AP-IT-GH/iot16-park-assist/src/parkeersensor/PCB design/README.md

##PCB design
In deze folder is het PCB design en multisim schema te vinden. Dit multisim schema is nodig geweest om tot het PCB design te komen.
In deze 2e revisie is er gekozen voor een grotere form factor waardoor alle componenten aan de bovenkant kunnen komen.
Als ook de hoeken zijn nu afgehoekt zodat dit overeenkomt met ons 3D case design.
Tevens enkele kleine componenten zijn toegevoegd zoals:
 - Led
 - Power switch
