AP-IT-GH/iot16-park-assist/doc/README.md

<!-- START doctoc generated TOC please keep comment here to allow auto update -->
<!-- DON'T EDIT THIS SECTION, INSTEAD RE-RUN doctoc TO UPDATE -->
**Table of Contents**  *generated with [DocToc](https://github.com/thlorenz/doctoc)*

- [Internet of Things - [Naam Project]](#internet-of-things---naam-project)

<!-- END doctoc generated TOC please keep comment here to allow auto update -->

# Internet of Things - [Naam Project]
Documentatie voor het project voor het vak Internet of Things.
