AP-IT-GH/iot16-park-assist/doc/deliverables.md

<!-- START doctoc generated TOC please keep comment here to allow auto update -->
<!-- DON'T EDIT THIS SECTION, INSTEAD RE-RUN doctoc TO UPDATE -->
**Table of Contents**  *generated with [DocToc](https://github.com/thlorenz/doctoc)*

- [Deliverables](#deliverables)
  - [Projectplan](#projectplan)
    - [Team](#team)
    - [Project keuze](#project-keuze)
    - [Projectbeschrijving](#projectbeschrijving)
    - [Functionele analyse:](#functionele-analyse)
      - [Technologieën](#technologie%C3%ABn)
      - [Inventarisatie Hardware](#inventarisatie-hardware)
      - [High Level Diagrammen](#high-level-diagrammen)
      - [Project Planning](#project-planning)
        - [Backlog:](#backlog)
        - [Planning](#planning)
  - [PCB Design](#pcb-design)
    - [1ste Versie](#1ste-versie)

<!-- END doctoc generated TOC please keep comment here to allow auto update -->

# Deliverables
Richtlijnen voor de te inleveren documenten.

**Dit zijn richtlijnen voor de documentatie. U bent zelf verantwoordelijk voor
de relevante documentatie**

## Projectplan
### Team
Mededeling van alle teamleden en een mapping naar de GitHub account (Dit is
voor niet identificeerbare gebruikersnamen bv: OurDarkLord) 

### Project keuze
Vermelding van toegeweze project.

### Projectbeschrijving 
Beschrijving van de team visie over het project, alle voorziene
project beschrijvingen zijn minimaal, er zijn nog enkele uitbreidingen /
features nodig om het project te laten slagen.

Minimaal 3000 tekens.

### Functionele analyse:
#### Technologieën
Verkenning van het technisch landschap, hier beschrijf je de technologieën die
interessant kunnen zijn voor jullie project. Je koppelt deze beschrijving met
functionaliteit / feature van het project. Je doet dit zowel voor hardware als
software.

#### Inventarisatie Hardware
Je maakt een lijst met de nodige hardware voor het project

#### High Level Diagrammen
Je maakt diagrammen die op een abstracte manier beschrijven hoe de
verschillende componenten aan elkaar hangen. Informatie dat je hier nog mee kan
weergeven zijn communicatie patronen, koppeling van hardware componenten. Dit
kunnen ook high level flowcharts zijn.

#### Project Planning
Link naar het gebruikte project managemennt tool

##### Backlog: 
Opsomming van de backlog items en beschrijving

##### Planning
Planning van sprint 1 & 2

## PCB Design
### 1ste Versie
