AP-IT-GH/iot16-park-assist/doc/timing.md

<!-- START doctoc generated TOC please keep comment here to allow auto update -->
<!-- DON'T EDIT THIS SECTION, INSTEAD RE-RUN doctoc TO UPDATE -->
**Table of Contents**  *generated with [DocToc](https://github.com/thlorenz/doctoc)*

- [Timing](#timing)

<!-- END doctoc generated TOC please keep comment here to allow auto update -->

# Timing

|Week |Beschrijving | 
|--- |--- |
|M1W1 |**Keuze project / Groepsindeling** | 
|M1W2 | | 
|M1W3 |Einde sprint #1 / **Indienen projectplan** | 
|M1W4 |Sprint #1 beoordeling / **Eerste ontwerp printplaat** | 
|M1W5 |Eerste versie printplaat / RC1 Software | 
|M1W6 |Einde sprint #2 | 
|M1EX |**Tussentijdse presentatie met demo** / beoordeling sprint #2 | 
|M2W1 |Start v2 printplaat / RC2 Software | 
|M2W2 | | 
|M2W3 | | 
|M2W4 |Einde Sprint #3 / **Revisie ontwerp printplaat** | 
|M2W5 |Evaluatie Sprint #3 | 
|M2W6 | | 
|M2W7 |Einde Sprint #4 / **Eindportfolio** | 
|M2EX |Eind evaluatie (+ Sprint #4) / **Presentatie** met demo | 

**Belangrijk:**
* *Code wordt elke dag ingecheckt*
* *Deliverables indien mogelijk in Markdown*
* *Deliverables staan in het vet*  
* *De deadline voor elke week is altijd zondag om 23u59.*
