AP-IT-GH/iot16-park-assist/doc/inbraakdetectiesysteem/img/badpackets.png

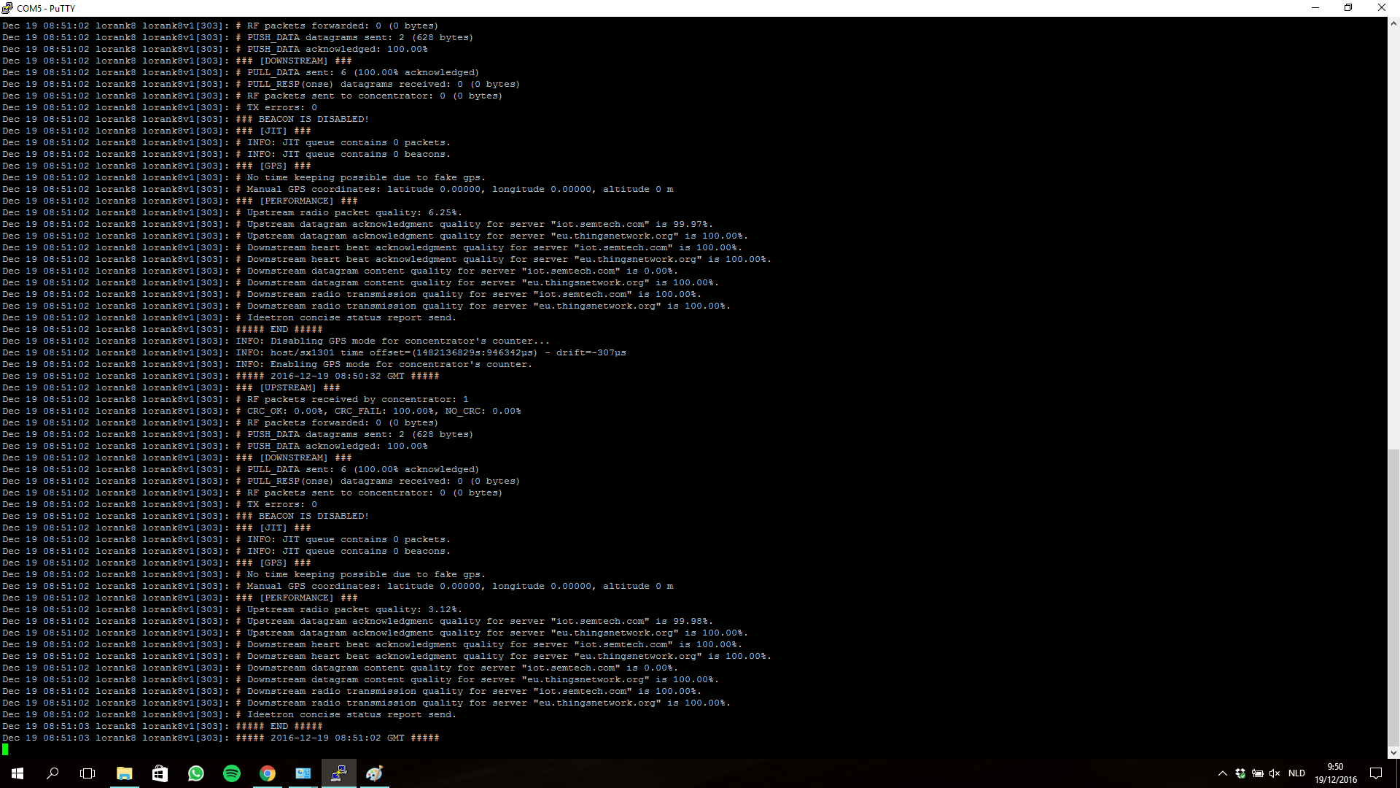
doc/inbraakdetectiesysteem/img/badpackets.png
