AP-IT-GH/iot16-park-assist/doc/inbraakdetectiesysteem/img/configuration.png

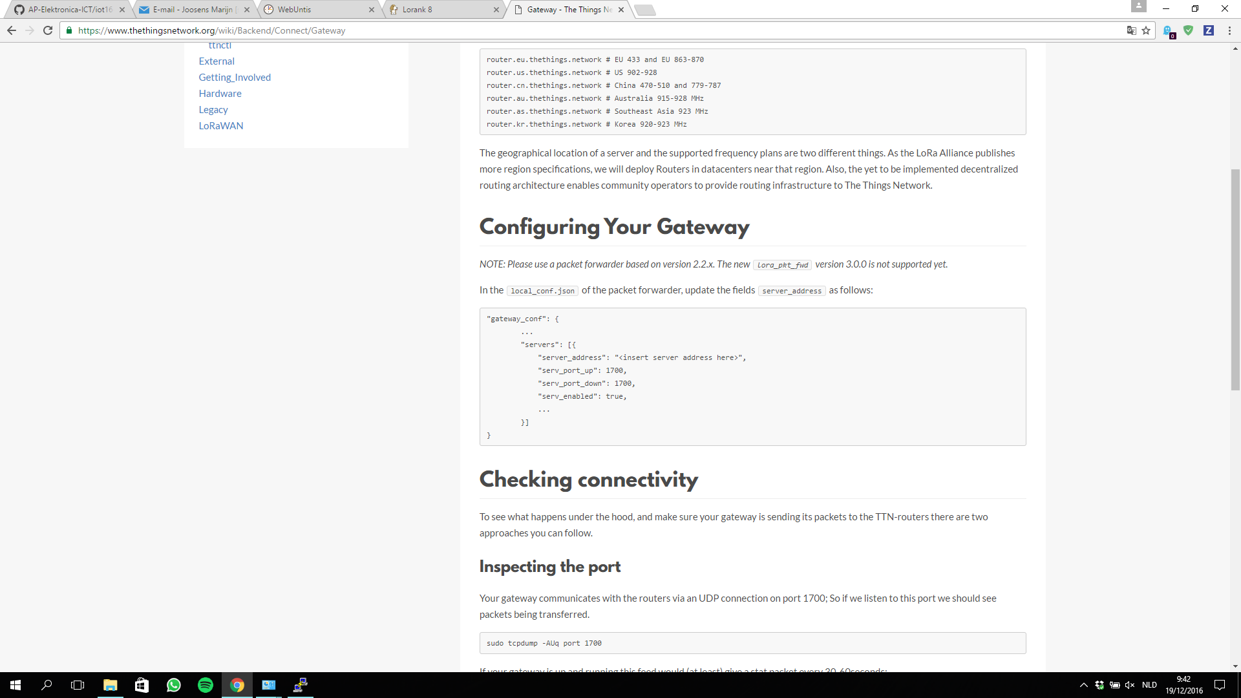
doc/inbraakdetectiesysteem/img/configuration.png
