AP-IT-GH/iot16-park-assist/doc/inbraakdetectiesysteem/img/onlinelogs.png

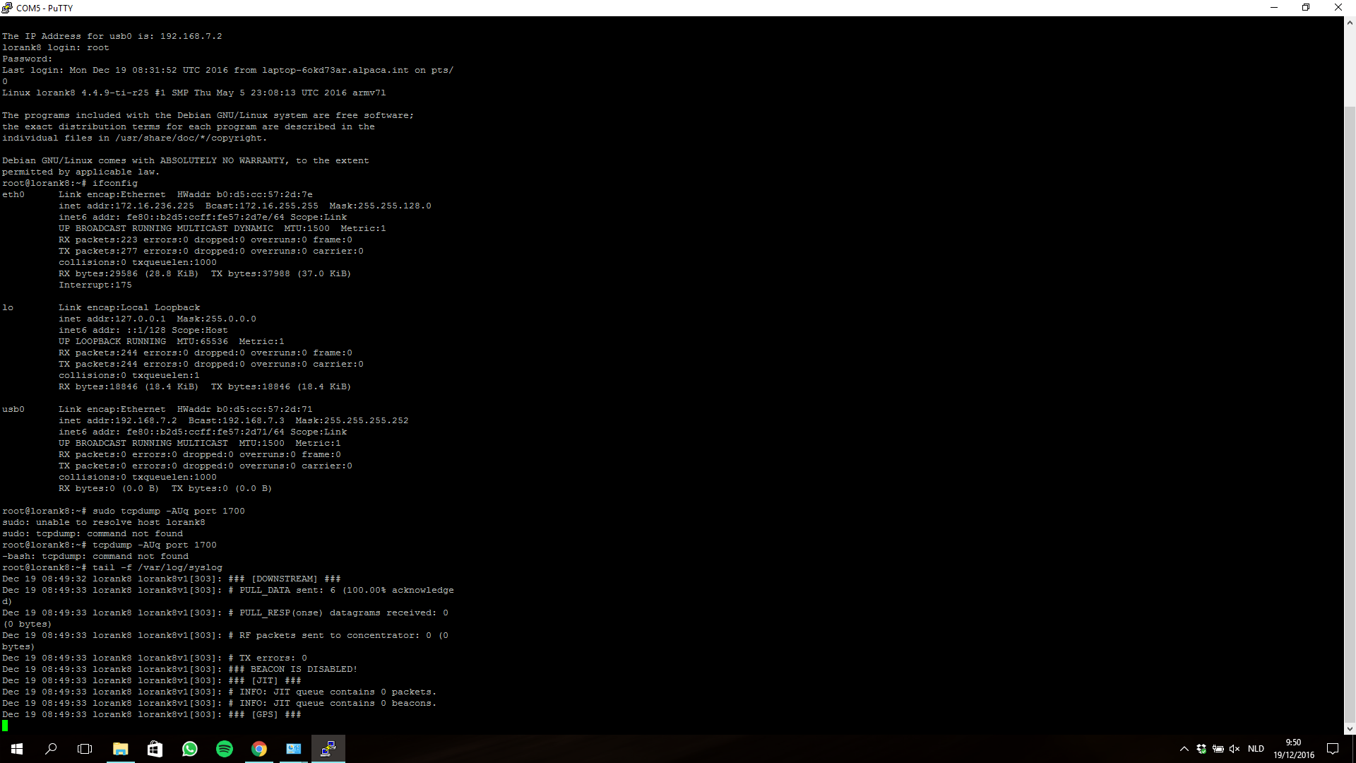
doc/inbraakdetectiesysteem/img/onlinelogs.png
