AP-IT-GH/iot16-park-assist/doc/Bill of materials.md

<!-- START doctoc generated TOC please keep comment here to allow auto update -->
<!-- DON'T EDIT THIS SECTION, INSTEAD RE-RUN doctoc TO UPDATE -->

- [Bill of materials](#bill-of-materials)
  - [Parkeer sensor](#parkeer-sensor)
  - [Inbraak detectie systeem](#inbraak-detectie-systeem)

<!-- END doctoc generated TOC please keep comment here to allow auto update -->

# Bill of materials
Dit document geeft alle componenten weer dat dit project nodig heeft om te maken.
## Parkeer sensor
*Prijzen kunnen variëren en is een globale inducatie van hoeveel het kan kosten. Prijzen zijn per stuk*

|#  | product 			| waarde 	| prijs 	| extra uitleg 				|
|---|---|---	|---|---				|
|1  |PCB design 		|n.v.t 	|€42,13  	|n.v.t 				|
|3 	|condensator		|0.1µF |€0,12 	|n.v.t 				|
|1	|LED 			|n.v.t 	|€1,00 	|n.v.t 				|
|3  |weerstand  		|2.2kΩ 	|€0,04 	|n.v.t 				|
|3  |weerstand  		|5MΩ 	|€0,06  	|n.v.t 				|
|1  |weerstand  		|220Ω 	|€0,05 	|n.v.t 				|
|3  |weerstand  		|330Ω 	|€0,05 		|n.v.t 					|
|1  |dipswitch  		|n.v.t 	|€2,00 	|n.v.t 				|
|3  |header 		|1x2 	|€0,35 	|batterij aansluiting 	|
|2  |header 		|1x15 	|€0,80 	|Arduino nano 			|
|3  |header 		|2x3 	|€0,60 	|batterij protectie systeem	|
|3  |header 		|1x3 	|€0,50 	|sensoren  					|
|3  |MOSFET 		|IRF530N |€0,50	  	|n.v.t  					|
|1  |Bt module 			|HC05 	|€7,50	  	|BT module 				|
|1  |Arduino 		|Nano  		|€4,18 	|n.v.t 					|
|1  |Ultra Sonic sensor |SEN136B5B  |€14,10  	|n.v.t 					|

Totale geschatte kosten (dit is met aantal opgeteld): €79,25
## Inbraak detectie systeem

*Prijzen kunnen variëren en is een globale inducatie van hoeveel het kan kosten. Prijzen zijn per stuk*

|#  | product 			| waarde 	| prijs 	| extra uitleg 				|
|---|---|---	|---|---				|
|1  |Lora gateway 		|LORANK 8  	|€386,00	|n.v.t 				|
|1 	|Lora mote 		|RN2483 |€66,37 	|n.v.t 				|
|1	|IR Distance Sensor	|GP0A41SK  	|€1,60  	|n.v.t 				|
|1  |Arduino  			|DUE 	|€25,99 	|n.v.t 				|
|1  |Bt module 			|HC05 	|€7,50  	|n.v.t		 			|

Totale geschatte kosten (dit is met aantal opgeteld): €487,46
