AP-IT-GH/iot16-park-assist/(list of files, drawings)

Other design files:
src/parkeersensor/PCB design/Park-Assist-Schema.ms13
