AP-IT-GH/iot16-park-assist/(commit log)

2016-09-29 code sensor distance reading
2016-10-16 Add arduino shematic & PCB Design
    [1 cell battery protect.ms13, Park-assist-Schema.ms13, UltrasonicSensor.ms13, battery-protection (Exemplaar met conflict van Marijn Joosens 2016-10-16).ms13, battery-protection.ms13, protection-with-blocks.ms13]
2016-10-18 snap sensors on block: success!
2016-10-18 Auto stash for revert of "Testing our new sensors"
2016-10-18 Sensor is now added with touch coo as mid
2016-10-27 Can delete sensors, but need bluetooth to be sure
2016-10-27 coö as mid: gone, deletesensor class: new
    had to comment out the code that was used to draw the sensor with his mid on the coö, otherwise this would give problems with deleting.
2016-12-21 Logs of the working arduino+mote combination
2016-12-27 arduino code for lora
2016-12-29 distance now according to sensordata
2017-01-13 add PCB functioneel blok
    [Park-Assist-Schema.ms13]
2017-01-13 add pcb design documentatie
2017-01-13 bill of materials begin
2017-01-14 toevoegingen pcb-design document
2017-01-14 edit pcb design doc including the 5 topics
2017-01-14 update bill of materials with table and prices
2017-01-14 additional images to pcb design doc
2017-01-14 add pcb design document to schema folder
2017-01-15 generate toc pcb-design doc
2017-01-15 pcb design in map parkeersensor
    [Park-Assist-Schema.ms13]
2017-01-15 TOC for BOM
2017-01-15 add flow chart
2017-01-15 some file changes
    [1 cell battery protect.ms13, Park-assist-Schema.ms13, UltrasonicSensor.ms13, battery-protection (Exemplaar met conflict van Marijn Joosens 2016-10-16).ms13, battery-protection.ms13, protection-with-blocks.ms13]
2017-01-15 update verhaal sensoren
2017-01-15 + flowchart
